wagiminator/ATtiny13-TinyProbe/hardware/TinyProbe_BOM_v1.0.tsv

ID | Name | Designator | Footprint | Quantity | Manufacturer Part | Manufacturer | Supplier | Supplier Part | LCSC Assembly
1 | MSK-11027 | KEY1 | SW_SMD_MSK-11027 | 1 | MSK-11027 Toggle Switches | ReliaPro | LCSC | C21381
2 | 470R | R3,R5,R4 | 0603 | 3 | 0603WAF4700T5E | UniOhm | LCSC | C23179
3 | 10k | R2,R1 | 0603 | 2 | 0603WAF1002T5E | UniOhm | LCSC | C25804
4 | 100k | R6 | 0603 | 1 | 0603WAF1003T5E | UniOhm | LCSC | C25803
5 | HI | LED2 | LED0603 | 1 | KT-0603R | KENTO | LCSC | C2286 | Yes
6 | ICSP | J2 | ICSP-PADS-SMALL | 1 | MTP125-1203S1 | MINTRON | LCSC | C358692
7 | OS | LED3 | LED0603 | 1 | 19-217/BHC-ZL1M2RY/3T | EVERLIGHT | LCSC | C72041 | Yes
8 | LO | LED1 | LED0603 | 1 | 19-217/GHC-YR1S2/3T | EVERLIGHT | LCSC | C72043 | Yes
9 | 100n | C1 | 0603 | 1 | CC0603KRX7R9BB104 | YAGEO | LCSC | C14663
10 | 47u | C2 | 1206 | 1 | 1206F476M160NT | FH | LCSC | C30300
11 | POGO | J3 | POGO | 1
12 | FL | LED4 | LED0603 | 1 | 19-213/Y2C-CQ2R2L/3T(CY) | EVERLIGHT | LCSC | C72038 | Yes
13 | PWR | J1 | HEADER_2X1 | 1 | 826629-2 | TE Connectivity | LCSC | C86471
14 | ATTINY13A-SSU | U1 | SOP-8_150MIL | 1 | ATTINY13A-SSU | MICROCHIP | LCSC | C14075
