wagiminator/ATtiny13-TinyProbe/hardware/TinyProbe_schematic_v1.0.pdf

## Microcontroller

## TTL/CMOS Selection Switch

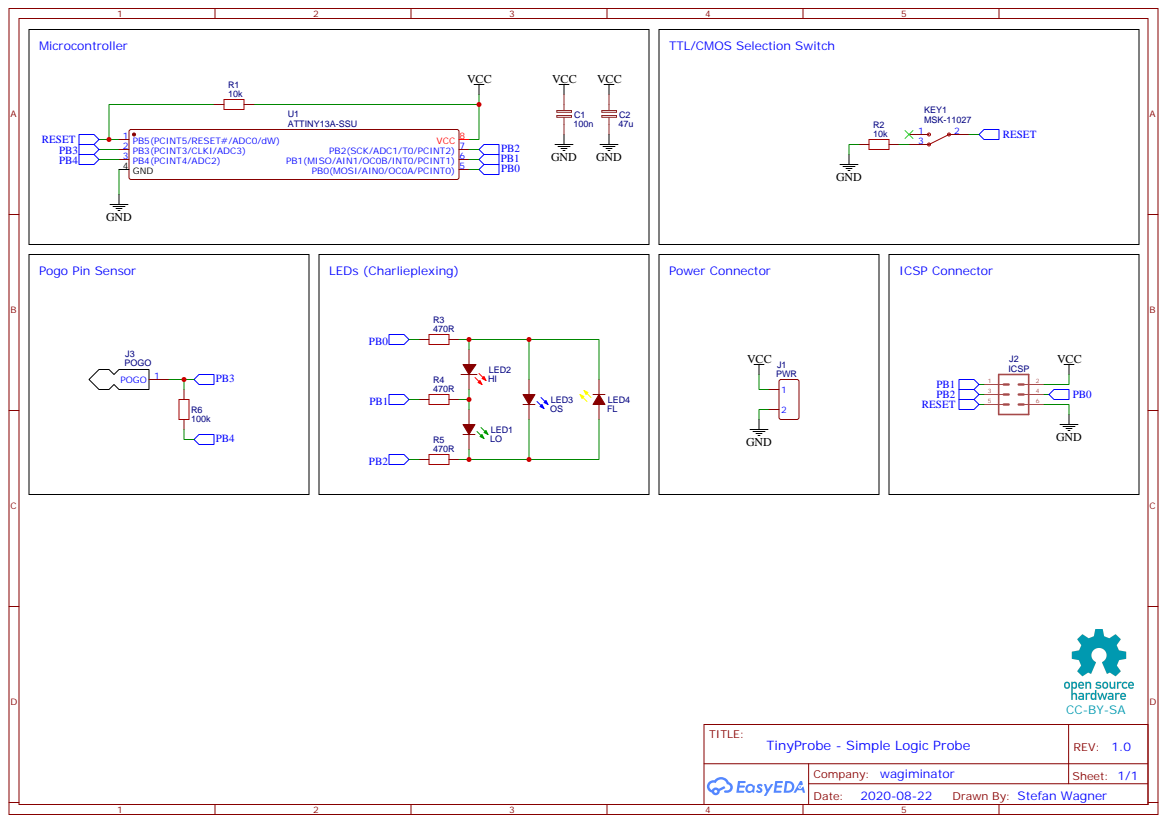
[picture p6: page 1]

Drawn By: Stefan Wagner
