wagiminator/ATtiny13-TinyProbe/(threads)

Thread 1 (2024-05-16):

How to burn firmware without ICSP?

nehcoab, 2024-05-16:
Hi, Stefan. I noticed that some of your boards using ATTiny don't have an ICSP. How do you usually program them?

nehcoab, 2024-05-16:
Is there something like a programming socket?

wagiminator, 2024-05-18:
Hi, since there is no ICSP header on the board (in order to save space), you have to program the ATtiny either before soldering using an [SOP adapter](https://aliexpress.com/wholesale?SearchText=sop-8+150mil+adapter), or after soldering using an [EEPROM clip](https://aliexpress.com/wholesale?SearchText=sop8+eeprom+programming+clip). The [AVR Programmer Adapter](https://github.com/wagiminator/AVR-Programmer/tree/master/AVR_Programmer_Adapter) can help with this.

nehcoab, 2024-05-20:
As you mentioned, I purchased an SOP8 clip, and the programming was successful. It's now working properly.
By the way, as a beginner, I have learned and replicated many of your projects, and they are all fantastic. Thanks for your open-source contributions.

wagiminator, 2024-05-20:
Always welcome !

Closed 2024-08-31.
